DuchkPy/MQTT2Ravelli/Documentation/img/circuit.png

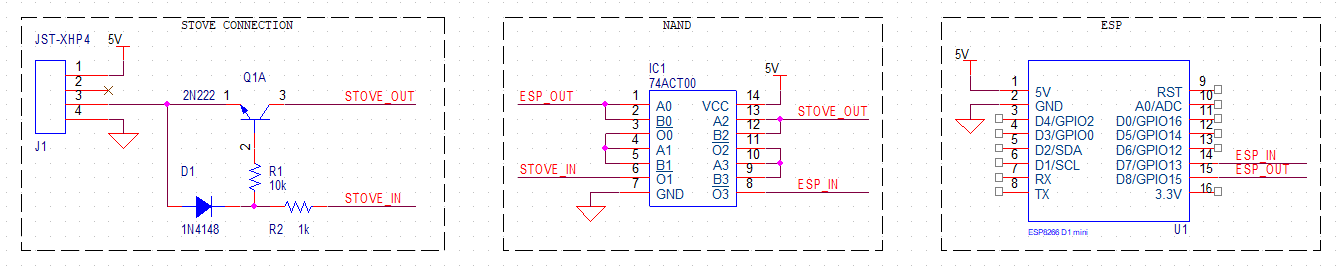
Documentation/img/circuit.png
