DuchkPy/MQTT2Ravelli/(threads)

Thread 2 (2022-12-11):

Problem code

ironhide9090, 2022-12-11:
hi, i'm having some problems with the code, i found an error writing "const char" it was spelled "consy char"
Now i stopped at "ValTemp += ((char)msgPayload[i]);" the error is :
"Compilation error: 'ValTemp' was not declared in this scope"
how can I do?
I am using for compile Arduino IDE 2.0.3
Thank you

DuchkPy, 2022-12-19:
Hello @ironhide9090

I just publish an update of the code that was outdated on this project compare to my local file (sorry for that).
Please give me a feedback here if it problems you were facing.

ironhide9090, 2022-12-20:
hi, thanks for the reply,
I checked the code and now it works, before connecting it I would like to know what dangers there are before burning the heater. if I measure with a tester between 0volt and the signal I have 2.9volt is it correct? Is the wiring diagram drawing safe?
sorry for the questions but I'm afraid he has to connect it and I would like to be sure.
I have the Ravelli HRV160 touch model

Thank you

DuchkPy, 2022-12-21:
> before connecting it I would like to know what dangers there are before burning the stove.

For sure, I completely understand your fears.
You have to be carefull on the orientation of the connector. as (coming from the stove) between ground +5V and the signal, the pin is a +18V.

Please take a look on the wiring I have on my demo-board, which is working :
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
Please note, I have updated the schematic based on this real part. As on previous I mixed wires between this +18V and the signal.

> I measure with a tester between 0volt and the signal I have 2.9volt is it correct?

On the stove or on the demo board ?
On the demo board, yes it's correct.
The stove is not sending any 3V. Only +18V, +5V, the signal (oscillating between 0 and 5V) and the ground. You can measure them to ensure correct wire harness orientation from the stove to your board.

ironhide9090, 2022-12-22:
Thanks, I measure 2.9 v on the demo board, these days I'll do some tests and update you!
Thanks again for your help

ironhide9090, 2022-12-22:
I see that in the photo you used a different transistor than mine, I used the BC109 as in the description, is it okay anyway? and as integrated the cd4011BE but from the HFC there are no differences.

DuchkPy, 2022-12-22:
For the transistor both works.
I put the BC109 on desceiption as I think it's more used (so people have it already on their stock).

I didn't catch whta you mean about the cd4011BE

ironhide9090, 2022-12-22:
I installed the CD4011BE instead of the HCF4011BE because I couldn't find it on the market but from the datasheet it's the same

DuchkPy, 2022-12-22:
Ohh ok, yes it should be a problem there. I noticed that a double NAND or a double AND door acheive at the same result

Nothing should be connected to the 18V of the stove. So the signal is connected to the 0-5V signal.

ironhide9090, 2022-12-23:
Ok perfetto, ti chiedo un ultima cosa, prima di collegarla volevo vedere il funzionamento della mqtt, c'è qualche comando da mqtt server che posso lanciare per vedere la comunicazione anche senza la reale connessione con la stufa?
Grazie ancora

DuchkPy, 2022-12-23:
You can run the command that provide an information you want (for example asking the setpointstatus, or the heatpowerstatus), if the stove doesn't answer you will have a message on the topic `topic_EspStatus` saying the answer from.the stove is incorrect.

ironhide9090, 2022-12-24:
OK thanks! Unfortunately I have now realized that in the purchase they sent me the 3.9k resistor and not 10k now time to replace it and I will do the tests ... to be sure I change all the elements
I will update you thanks

TruantRiccardo, 2023-01-08:
> hi, thanks for the reply, I checked the code and now it works, before connecting it I would like to know what dangers there are before burning the stove. if I measure with a tester between 0volt and the signal I have 2.9volt is it correct? Is the wiring diagram drawing safe? Is the signal connected on pin2 like the pyton diagram next to the 5v? sorry for the questions but before connecting I would like to be sure. I have the Ravelli-HRV160-touch model
>
> Thank you

Sorry to bother you. Since I have the same stove as you, may I ask you if you have been able to control it? The code seems to work but I don't know if the serial messages are the same for our stove.

> You can run the command that provide an information you want (for example asking the setpointstatus, or the heatpowerstatus), if the stove doesn't answer you will have a message on the topic `topic_EspStatus` saying the answer from.the stove is incorrect.

Thanks for your big contribution, I still have to complete the board but the code is very well done. May I ask how you managed to reverse-engineer the serial messages?

DuchkPy, 2023-01-08:
Hello @TruantRiccardo,

> Thanks for your big contribution, I still have to complete the board but the code is very well done

Thank you. I tried to make it clear and with enough comments to allow everybody to be able to use it.

> May I ask how you managed to reverse-engineer the serial messages?

Sure, I'm open to indicate and support anyone who wants to use this project.
In fact, I made a dedicated wire harness to link the stove to the remote control, with one derivation on the signal wire. An I plugged this derivation to an oscilloscope. Them I played with my remote control and looked on the oscilloscope both request and reply from/to the remote control.

> Since I have the same stove as you

Please note that all stove using this remote control are using the same code.
The dealer of my stove confirmed me that he doesn't have to configure the remote control to indicate the version of the stove. Only difference is on the fact that some stove have a venting system on the front panel (like mine), some don't. I also saw someone with a venting on the back (I don't know how to control it).

ironhide9090, 2023-01-09:
hello, I managed to complete the electronic card, I have a doubt if measured in Volt between positive and signal I get 4.7v if instead measured between 0v and signal I get 0volt, before you told me that I got about 2.5volt now I don't see this value .
Unfortunately I don't have an oscilloscope to use, I can only rely on these measurements.
Thank you

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

TruantRiccardo, 2023-01-10:
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

I understand now and thanks for the clarification about Ravelli using the same messages for all the stoves that have this remote control.
I was thinking about the "transceiver" part of the circuit. Could it be better to use a CAN transceiver(e.g. MCP2551)? In this way, you use the TTL part for the ESP and the CANH for the stove.
About your solution, I am a bit worried when Stove is transmitting high and ESP_out is low. In this situation at the cathode of D1( node D1-R1) you are "forcing" both 5V from the stove and 0V from the HCF4001. I don't know if this can damage the diode or the NAND IC or if I am not considering something.

TruantRiccardo, 2023-01-11:
I have simulated what i am talking about (the generator and the not gate are ideal, so I am not taking into account the series resistance. The current will be a little lower but the problem remains).
As you can see, when the Stove is at 5V and esp out is at 0V there are 2.6A passing through the diode (which is rated 2A peak current). I think that you haven't seen any damage because this situation lasts for (1/4800)s but I don't know if in the long run can damage the circuit or the stove.

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

DuchkPy, 2023-01-16:
Hello @TruantRiccardo,

I understand what you mean and the potential risk.
Honnestly, you seems to know more electronic than me. I just looked at what the signal was looking like between the stove and the remote control and saw a possibility to drive it through the serial port of an ESP. Unfortunately (at least it seems, based on what you are showing) I wasn't aware of this major detail than can damage some components.

I'm open to any proposal on this repo on a fork on your repo.

TruantRiccardo, 2023-01-16:
Hi @DuchkPy don't worry, you have done a great job. I have successfully communicate with the stove last night. I have added a 1kohm resistor between the cathode of the diode and the output of the nand. In this way you limit the current under 10mA in that situation. I have opened the remote to understand how the micro inside it talk and I notice that there isn't a transceiver. Since the trace goes under the screen i couldn't know what pin it uses for the communication but I will try this week with a tester, just to understand better how it works. Tonight i will upload an updated schematic and a bug fix for the sw. Using pin D7 and D8 i had to add serial.swap() after serial.begin(). I haven't tested all commands but I notice that if I publish "Stove status" the esp will keep demanding the status to the stove and publish in loop forever. If I publish "setpoint temp status" i receive 0. if I publish "setpoint temp" the esp respond nok even if I hear the stove beep. Instead OnOff work like a charm. Tonight i will investigate about these problems.

ironhide9090, 2023-02-01:
Not being sure of the voltage emitted by the card as I asked you above, I was afraid and stopped... I don't know if I made a mistake or if I have some defective component...

DuchkPy, 2023-02-01:
Ok !
Please keep me inform when you will have tested it, with this hardware update.

Thread 7 (2023-01-20):

Unable to send SetPoint temperature and undefined stove status

TruantRiccardo, 2023-01-20:
if I try to send the request for a Temperature Setpoint, the stove will answer saying that the setpoint is 0. (read from the bottom up)
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

If I ask what the temperature setpoint is, the response is in fact zero.
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

I have even tried sending via MQTT every 15 minutes the room temperature. I don't know if it matters.

Another thing that I notice is that the stove status goes to an undefined condition periodically when the stove is on.
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

Here you can see the history, maybe it's the "modulation" status. If so, maybe the messages are a little different from model to model?
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

DuchkPy, 2023-01-30:
Hello @TruantRiccardo

Looking at your `StoveStatus` reply, I can see different values that I have already seen. It's possible I haven't seen all cases.
On your reply,
- the stove status is `13`, and I have only seen up to `11`. So this one need to be investigated.
- the alarm state is `10`, and I have only seen up to `8`. So this one need to be investigated.

For `SetpointTemp`, I can see that the command send have a value of `15`, but the stove reply he received an order of `0`... (see message n°13 and 14).

Looking at that, I start to think that all stove haven't the same hexa frame for the same order...
Which (to be honest) looks stupid, because the remote need to understand what is the stove plug to it. Having the same frame ease the development by doing it only once...

TruantRiccardo, 2023-01-31:
Hi @DuchkPy

For `StoveStatus` I can confirm that the stove status `0x13` is H2O modulation, while the alarm status `0x10` I believe is a kind of "in operation".
Using debug messages I found new status codes up to `0x1a`. I will send a new commit with the new codes shortly.

Regarding `SetpointTemp`, I too find it very strange that they change the messages. One thing that got me thinking is that the stove accepts the exact frame and responds with the expected frame (except those 8 bits). If I want to use different messages for different stoves, it would be silly to use the same frame for different actions for different stoves. At least the stoves would have to respond with a different frame.... I don't know if I explained myself. What I was thinking is that the message is correct but there is some "protection" or some setting in the remote control that does not allow me to read/write that register.

I was thinking of borrowing an oscilloscope from my workplace so that I can read the commands. So probably i will update you soon.

For the moment I am using a workaround to control the setpoint temperature, maybe it may be useful to others:
-The` SetPointTemperature` of the stove, since I cannot set it from the serial, is the last one I set from the remote control [e.g. 20°C].
The same goes for the H2O setpoint [e.g. 70°C] although it does not matter for this workaround.
-I can send the `room temperature` via serial and the stove uses this temperature as a reference for its setpoint.
-From Home Assistant, I create an `Input_Number` entity where I enter my setpoint.
- From HA, I create a new `sensor` entity that takes the temperature from a real-time temperature sensor and corrects it by adding/subtracting the difference between the desired setpoint [e.g. 22°C] and the last remote control setpoint [e.g. 20°C].

DuchkPy, 2023-01-31:
>  I don't know if I explained myself

You explained it correctly, and I have the same point of view.
My dealer told me there is only 1 reference of remote control. So from my point of view the remote control have only 1 software whatever the stove model.

> I was thinking of borrowing an oscilloscope from my workplace so that I can read the commands.

This is exactly how I did.
It could be interesting if you are able to do it. We could understand a bit better / faster what are the difference. And confirm the `0x13` you saw. I could have miss it, like some others.

But, if you do it, be aware that the remote control is spamming the stove. It's almost a constant discussion between both (all discussions are initiated by the remote control, sending a request or a status and waiting for the answer from the stove).
As you look more familiar with electronic that I am, maybe you will be able to build a proto board that can read the message to record them on a computer. Could be more confortable than on an oscilloscope.
I tried, but when I plugged my electronic in parallel the remote control put it itself as unconnected. Like the remote detected the parallel electronic and stopped interacting with the stove (without damaging it at all, just need to unplug the electronic and the remote act again normally).

DuchkPy, 2023-02-01:
From the first example I found here : https://randomnerdtutorials.com/esp8266-nodemcu-webserial-library/
They are using `WebSerial.println()` and `Serial.println()` so seems possible to do both at the same time yes.

So something very simple like this should work:
```
void loop() {
  if (Serial.available()>0) {
    WebSerial.println(String(Serial.read(), HEX));
  }
}
```

TruantRiccardo, 2023-02-02:
Yes, that's what I was thinking about. Tomorrow or this weekend I will make the harness for testing.

Thread 9 (2023-07-06):

Issues With Serial Communication

SimonRichards, 2023-07-06:
Hi, I have a Ravelli Dual 7 but I see from your comments that the model should not matter much. I would appreciate any help in getting this working. I have built the circuit around a nodemcu 1.0 (v3) according to your circuit diagram. It's a bit messy but I hope it is accurate.
When I plug the board into the "remote" port on the stove it receives 5V, connects to my wifi and happily communicates with my mqtt broker.
Unfortunately all of the messages sent and received between the device and the stove (that I can see in the *_tx and *_rx topics) are all just ff_ff_ff_ff. I assume this means that there is an issue with the voltage or frequency of the serial comms, however I am not equipped with the tools or skills to fix this so I was hoping you would have some pointers.

I was wondering about the difference between the two ports on my stove (and maybe yours?), they are both 4 pins and both supply 5V. One is called serial and the other remote. The plug you specified fits into the port labelled remote, I can also plug my RF remote into this port with its supplied cable and it can control the stove this way, instead of via rf. However when I power my board on this port, even without touching the serial pin, the RF remote loses access to the stove.

If the "remote" port is the correct port for me to be using, what is the purpose of the "serial" port, would it be possible to move the device over to that? Even if I could get this working I would hate to lose the functionality of the remote and depend entirely on mqtt messages.

Thanks in advance.

DuchkPy, 2023-11-14:
Hello @SimonRichards,

First of all, I need to apologize for lead time to answer you. I didn't received any notification from GitHub, so I missed it.
Anyway, I will try to support you us best as possible, from now on.
Even if currently this project isn't plugged full time to the stove yet. So I can't confirm that everything is working correctly at any time.

> Unfortunately all of the messages sent and received between the device and the stove (that I can see in the *_tx and *_rx topics) are all just ff_ff_ff_ff.

This is something I already faced with, and I need to reinstall it on the bench to check this point.
I will update your opened issue once (not this week) I will have answer to bring on the table.

> I was wondering about the difference between the two ports on my stove (and maybe yours?), they are both 4 pins and both supply 5V. One is called serial and the other remote

I worked on the port called remote. And yes, it does deactivate the connection with remote once you plug the board.
In fact, during the development I plugged the remote to the stove and made a derivation to listen the communication, then  I copied it to this project. I don't know what is happening on the other port (voltage, communication, ...)

> what is the purpose of the "serial" port

This other port is to plug external device to have a remote connection using the [Ravelli Smart WiFi](https://eng.ravelligroup.it/innovations/technology/smart-wifi/). My wife manage to have it installed (free of charge), that's why I'm not really anymore using this project. But this Ravelli equipment can't do as much as the remote.
One day, I will take time to listen the communication too ;-)

t0ny2011, 2025-01-19:
Hi, I build the project and I am facing the same issue.
Al responses are Tx = ff_ff_ff_ff_ff_ff_ff_ and Rx = ff_ff_ff_ff_ff_ff_ff_ff_ff_ff_ff_
Did you find a solution for it?

Thread 10 (2023-12-20):

Ravelli RC70

esavalle, 2023-12-20:
Hi there,

I would like to integrate your code into my Ravelli RC70 stove. On this one, the TOUCH remote control doesn't exist, but I have a 4-pin "Serial" port behind the stove's main screen.
On the multimeter, I measure a GND pin, a 3.3V pin and a 12V pin. I have no information on the fourth pin.
Do you have any idea what I can test to see if the stove can be controlled by your work?

Cheers,

DuchkPy, 2023-12-30:
Hello @esavalle,

The `serial` port is to connect another interface than the one on this project.
I know that the WiFi remote connection sold by Ravelli can be plugged-in there.

The project here needs to be plugged on the `remote` port.

esavalle, 2023-12-30:
Thank you for your answer, also I will not be able to use your project, I found this : https://esphome.io/components/micronova.html which should be what I need !

Closed 2024-01-02.
