DuchkPy/MQTT2Ravelli/(commit log)

2022-10-10 Update circuit
    Add wire harness information
2022-12-19 Update Circuit.png
    To include wire harness detail
2022-12-21 Update wire harness
2023-01-08 FIX BUG: unable to read msg Topic
    brought out from the loop the initialization of the string msg_topic
    [MQTT2Ravelli.ino]
2023-01-18 BUG FIX: MQTT Loop Stuck, wrong UART. Added MQTT Debug
    fixed MQTT infinite loop, changed UART to be compatible with the schematic. Added MQTT Debug messages about the serial communication.
    [MQTT2Ravelli.ino]
2023-01-18 Updated Schematic
    Added resistor to limit diode current during Stove communication.
    Changed NAND port to deliver a higher output current.
    NAND port at 5V (ESP DIO are 5V tolerant)
2023-02-02 Update Readme BOM
