DuchkPy/MQTT2Ravelli/(notices)

Notices in the files:
src/MQTT2Ravelli/Crc16.h:
"MIT Open Source Software License":
Permission is hereby granted, free of charge, to any person obtaining a copy of
this software and associated documentation files (the "Software"), to deal in the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
